pjabardo/mcp3208esp32/README.md

# mcp3208esp32
MCP3208 data acquisition with ESP32
