pjabardo/mcp3208esp32/kicad/mcp3208esp32.kicad_pcb

## KiCad design kicad/mcp3208esp32.kicad_pcb (2020-10-18)

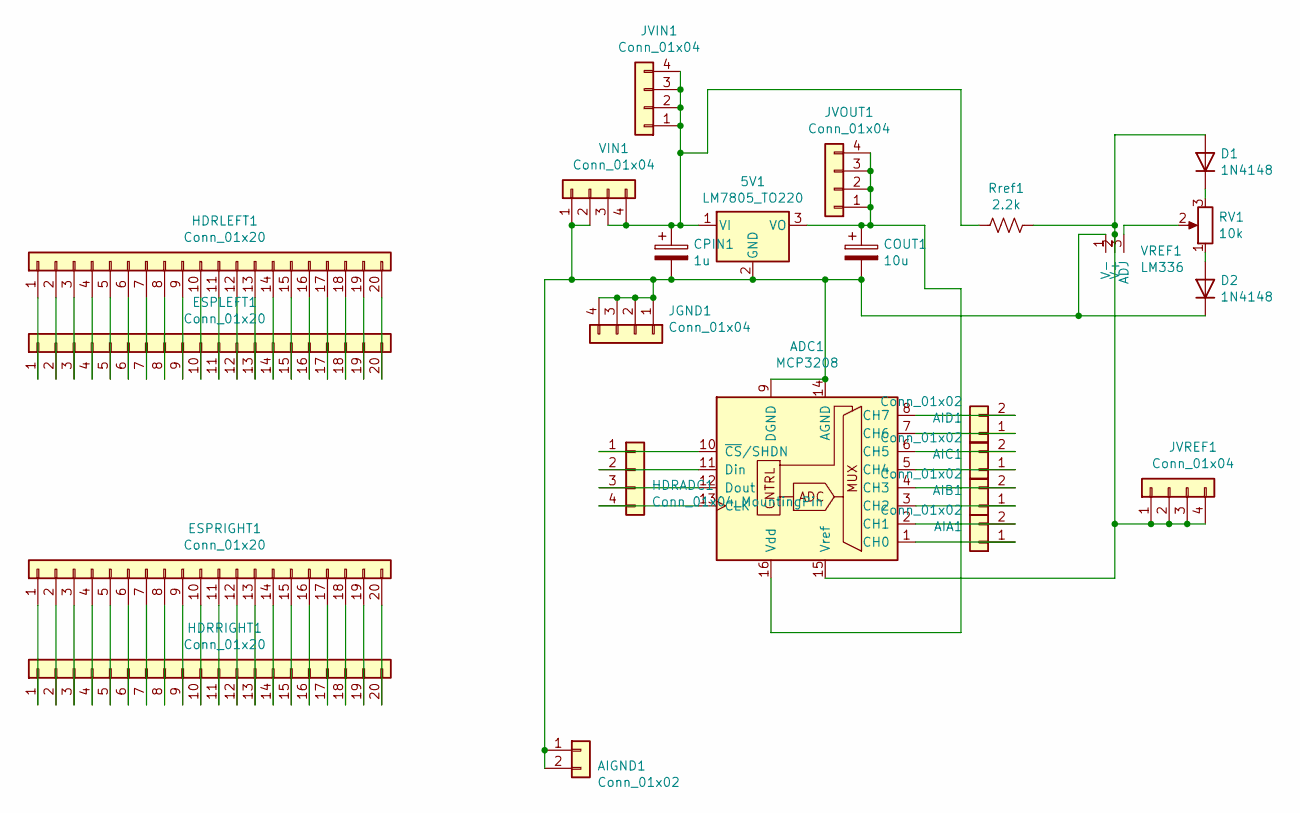
[picture p1: schematic mcp3208esp32.sch]

Parts:
5V1: LM7805_TO220; TO-220-3_Vertical
ADC1: MCP3208; DIP-16_W7.62mm
AIA1: Conn_01x02; TerminalBlock_bornier-2_P5.08mm
AIB1: Conn_01x02; TerminalBlock_bornier-2_P5.08mm
AIC1: Conn_01x02; TerminalBlock_bornier-2_P5.08mm
AID1: Conn_01x02; TerminalBlock_bornier-2_P5.08mm
AIGND1: Conn_01x02; TerminalBlock_bornier-2_P5.08mm
COUT1: 10u; CP_Radial_D5.0mm_P2.00mm
CPIN1: 1u; CP_Radial_D5.0mm_P2.00mm
D1, D2: 1N4148; D_DO-35_SOD27_P7.62mm_Horizontal
ESPLEFT1: Conn_01x20; PinSocket_1x20_P2.54mm_Vertical
ESPRIGHT1: Conn_01x20; PinSocket_1x20_P2.54mm_Vertical
HDRADC1: Conn_01x04_MountingPin; PinHeader_1x04_P2.54mm_Vertical
HDRLEFT1: Conn_01x20; PinHeader_1x20_P2.54mm_Vertical
HDRRIGHT1: Conn_01x20; PinHeader_1x20_P2.54mm_Vertical
JGND1: Conn_01x04; PinHeader_1x04_P2.54mm_Vertical
JVIN1: Conn_01x04; PinHeader_1x04_P2.54mm_Vertical
JVOUT1: Conn_01x04; PinHeader_1x04_P2.54mm_Vertical
JVREF1: Conn_01x04; PinHeader_1x04_P2.54mm_Vertical
RV1: 10k; Potentiometer_Bourns_3296W_Vertical
Rref1: 2.2k; R_Axial_DIN0207_L6.3mm_D2.5mm_P10.16mm_Horizontal
VIN1: Conn_01x04; TerminalBlock_bornier-4_P5.08mm
VREF1: LM336; TO-92L_Inline

Connections:
unnamed: 5V1.1 (VI), CPIN1.1, JVIN1.1, JVIN1.2, JVIN1.3, JVIN1.4, Rref1.2, VIN1.3, VIN1.4
unnamed: 5V1.2 (GND), ADC1.9 (DGND), ADC1.14 (AGND), AIGND1.1, AIGND1.2, COUT1.2, CPIN1.2, D2.1 (K), JGND1.1, JGND1.2, JGND1.3, JGND1.4, VIN1.1, VIN1.2, VREF1.1 (V-)
unnamed: 5V1.3 (VO), ADC1.16 (Vdd), COUT1.1, JVOUT1.1, JVOUT1.2, JVOUT1.3, JVOUT1.4
unnamed: ADC1.1 (CH0), AIA1.1
unnamed: ADC1.2 (CH1), AIA1.2
unnamed: ADC1.3 (CH2), AIB1.1
unnamed: ADC1.4 (CH3), AIB1.2
unnamed: ADC1.5 (CH4), AIC1.1
unnamed: ADC1.6 (CH5), AIC1.2
unnamed: ADC1.7 (CH6), AID1.1
unnamed: ADC1.8 (CH7), AID1.2
unnamed: ADC1.10 (~CS~/SHDN), HDRADC1.1
unnamed: ADC1.11 (Din), HDRADC1.2
unnamed: ADC1.12 (Dout), HDRADC1.3
unnamed: ADC1.13 (CLK), HDRADC1.4
unnamed: ADC1.15 (Vref), D1.2 (A), JVREF1.1, JVREF1.2, JVREF1.3, JVREF1.4, Rref1.1, VREF1.2 (V+)
unnamed: D1.1 (K), RV1.3
unnamed: D2.2 (A), RV1.1
unnamed: ESPLEFT1.1, HDRLEFT1.1
unnamed: ESPLEFT1.2, HDRLEFT1.2
unnamed: ESPLEFT1.3, HDRLEFT1.3
unnamed: ESPLEFT1.4, HDRLEFT1.4
unnamed: ESPLEFT1.5, HDRLEFT1.5
unnamed: ESPLEFT1.6, HDRLEFT1.6
unnamed: ESPLEFT1.7, HDRLEFT1.7
unnamed: ESPLEFT1.8, HDRLEFT1.8
unnamed: ESPLEFT1.9, HDRLEFT1.9
unnamed: ESPLEFT1.10, HDRLEFT1.10
unnamed: ESPLEFT1.11, HDRLEFT1.11
unnamed: ESPLEFT1.12, HDRLEFT1.12
unnamed: ESPLEFT1.13, HDRLEFT1.13
unnamed: ESPLEFT1.14, HDRLEFT1.14
unnamed: ESPLEFT1.15, HDRLEFT1.15
unnamed: ESPLEFT1.16, HDRLEFT1.16
unnamed: ESPLEFT1.17, HDRLEFT1.17
unnamed: ESPLEFT1.18, HDRLEFT1.18
unnamed: ESPLEFT1.19, HDRLEFT1.19
unnamed: ESPLEFT1.20, HDRLEFT1.20
unnamed: ESPRIGHT1.1, HDRRIGHT1.1
unnamed: ESPRIGHT1.2, HDRRIGHT1.2
unnamed: ESPRIGHT1.3, HDRRIGHT1.3
unnamed: ESPRIGHT1.4, HDRRIGHT1.4
unnamed: ESPRIGHT1.5, HDRRIGHT1.5
unnamed: ESPRIGHT1.6, HDRRIGHT1.6
unnamed: ESPRIGHT1.7, HDRRIGHT1.7
unnamed: ESPRIGHT1.8, HDRRIGHT1.8
unnamed: ESPRIGHT1.9, HDRRIGHT1.9
unnamed: ESPRIGHT1.10, HDRRIGHT1.10
unnamed: ESPRIGHT1.11, HDRRIGHT1.11
unnamed: ESPRIGHT1.12, HDRRIGHT1.12
unnamed: ESPRIGHT1.13, HDRRIGHT1.13
unnamed: ESPRIGHT1.14, HDRRIGHT1.14
unnamed: ESPRIGHT1.15, HDRRIGHT1.15
unnamed: ESPRIGHT1.16, HDRRIGHT1.16
unnamed: ESPRIGHT1.17, HDRRIGHT1.17
unnamed: ESPRIGHT1.18, HDRRIGHT1.18
unnamed: ESPRIGHT1.19, HDRRIGHT1.19
unnamed: ESPRIGHT1.20, HDRRIGHT1.20
unnamed: RV1.2, VREF1.3 (ADJ)

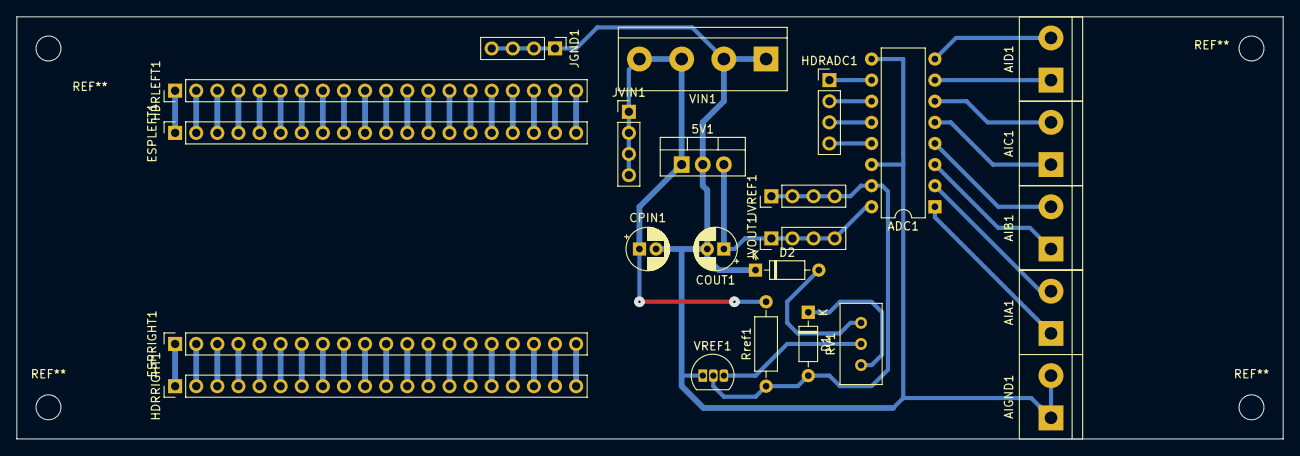
[picture p2: board mcp3208esp32.kicad_pcb from above]

Board: 2 copper layers, 152.4 x 50.8 mm, 24 parts (0 on the bottom side), 59 nets.
