pjabardo/mcp3208esp32/(commit log)

2020-10-12 Initial commit of the mcp3208esp32 project.
    For now I am just adding the board.
    [mcp3208esp32.kicad_pcb, mcp3208esp32.sch]
2020-10-12 Modified the source of the voltage reference
    Now it uses the input voltage in contrast to before when the regulated 5V was the source for the reference voltage. This is an improvement because now the board can use 5V or 2.5V reference.
    [mcp3208esp32.kicad_pcb, mcp3208esp32.sch]
2020-10-14 Started working on the software
    For now I'm using the example on Mcp320x library. It is not working but I suspect that this is due to the use of the input buffers: If there is no input, the output from the op amp is unstable. A possible solution is to use a pull down resistor (or pull up) so that it stabilizes op amp output. A large resistor (1M) should work.
    This might not be the best solution. Perhaps a better op amp could be used. Since signal conditioning will be used, it might be interesting to eliminate the buffer entirely. It will be much simpler.
    [espdaq.ino]
2020-10-16 Removed the operational amplifier
    It was not working and not helping. So for now I removed it.
    I also added a header connector that exposes the reference voltage to other applications.
    [mcp3208esp32.sch]
2020-10-17 Updated the pcb without the op amps
    AGND and DGND are connected. Any signal conditioning will have to be done upstream.
    [mcp3208esp32.kicad_pcb, mcp3208esp32.sch]
2020-10-18 Built the board and tested it. It is working
    Now I need to write the software side of it.
    [mcp3208esp32.kicad_pcb]
